will127534/HITCON-Badge-2018/README.md

# HITCON-Badge-2018
HITCON Badge 2018 files
