will127534/HITCON-Badge-2018/Software/Utlity/SecureElement_Uploader/README.md

## Secure Element Upload tool

Usage:
First, Upload relay bin (SLE97Loader.ino.bin) to MT7697  

Second, Run the python program  
``` python
python3 ./SLE97Loader.py. BINFILE COM_PORT
#EX:python3 ./SLE97Loader.py SLE97_20180720.out COM3
```
