will127534/HITCON-Badge-2018/Software/Utlity/UploadTool/README.md

## Linkit 7697 Upload Tool

使用方式如下:

``` 
upload.exe -n da97.bin -c COM5 -f [bin file location]

```
