will127534/HITCON-Badge-2018/Software/Utlity/BMPtobinaryBitmap/HITCON.bmp

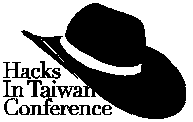
Software/Utlity/BMPtobinaryBitmap/HITCON.bmp
