will127534/HITCON-Badge-2018/Software/Utlity/BMPtobinaryBitmap/Hitcon_L0.bmp

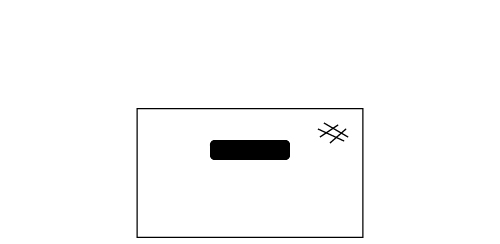
Software/Utlity/BMPtobinaryBitmap/Hitcon_L0.bmp
