will127534/HITCON-Badge-2018/Software/Utlity/BMPtobinaryBitmap/Hitcon_L2.bmp

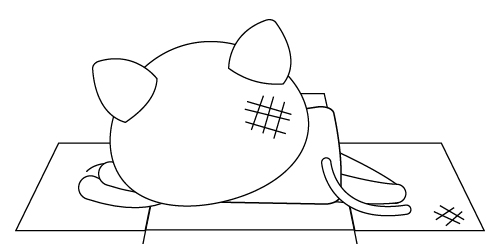
Software/Utlity/BMPtobinaryBitmap/Hitcon_L2.bmp
