will127534/HITCON-Badge-2018/Software/Utlity/BMPtobinaryBitmap/Hitcon_L3a.bmp

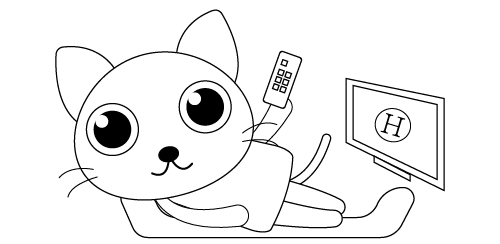
Software/Utlity/BMPtobinaryBitmap/Hitcon_L3a.bmp
