will127534/HITCON-Badge-2018/Software/Utlity/BMPtobinaryBitmap/Hitcon_L4a.bmp

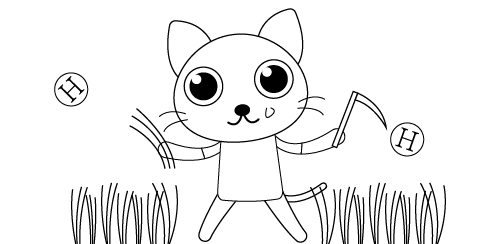
Software/Utlity/BMPtobinaryBitmap/Hitcon_L4a.bmp
