will127534/HITCON-Badge-2018/Software/Utlity/BMPtobinaryBitmap/Hitcon_L5a.bmp

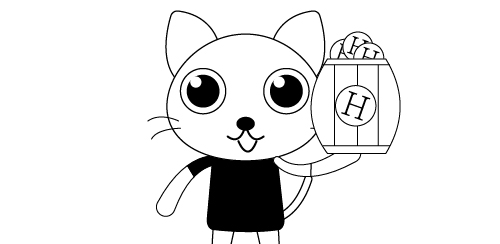
Software/Utlity/BMPtobinaryBitmap/Hitcon_L5a.bmp
