will127534/HITCON-Badge-2018/Software/Utlity/BMPtobinaryBitmap/Hitcon_L7.bmp

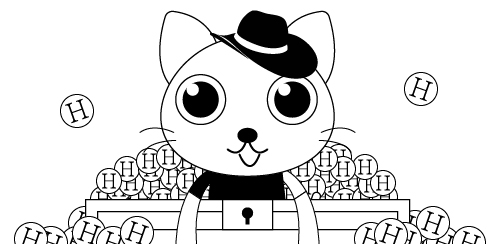
Software/Utlity/BMPtobinaryBitmap/Hitcon_L7.bmp
