will127534/HITCON-Badge-2018/Software/Utlity/BMPtobinaryBitmap/Might.bmp

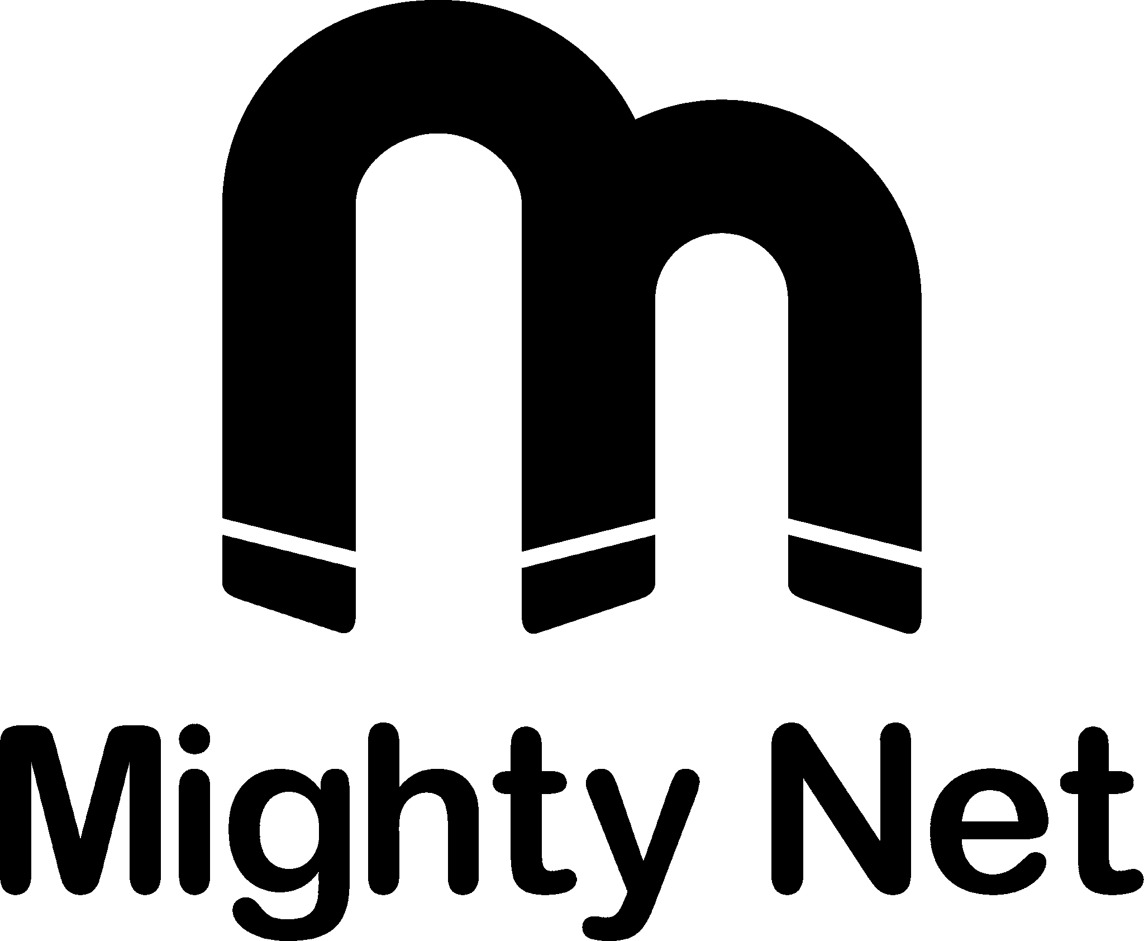
Software/Utlity/BMPtobinaryBitmap/Might.bmp
