will127534/HITCON-Badge-2018/Hardware/HitconBadge2018_Schmetic.pdf

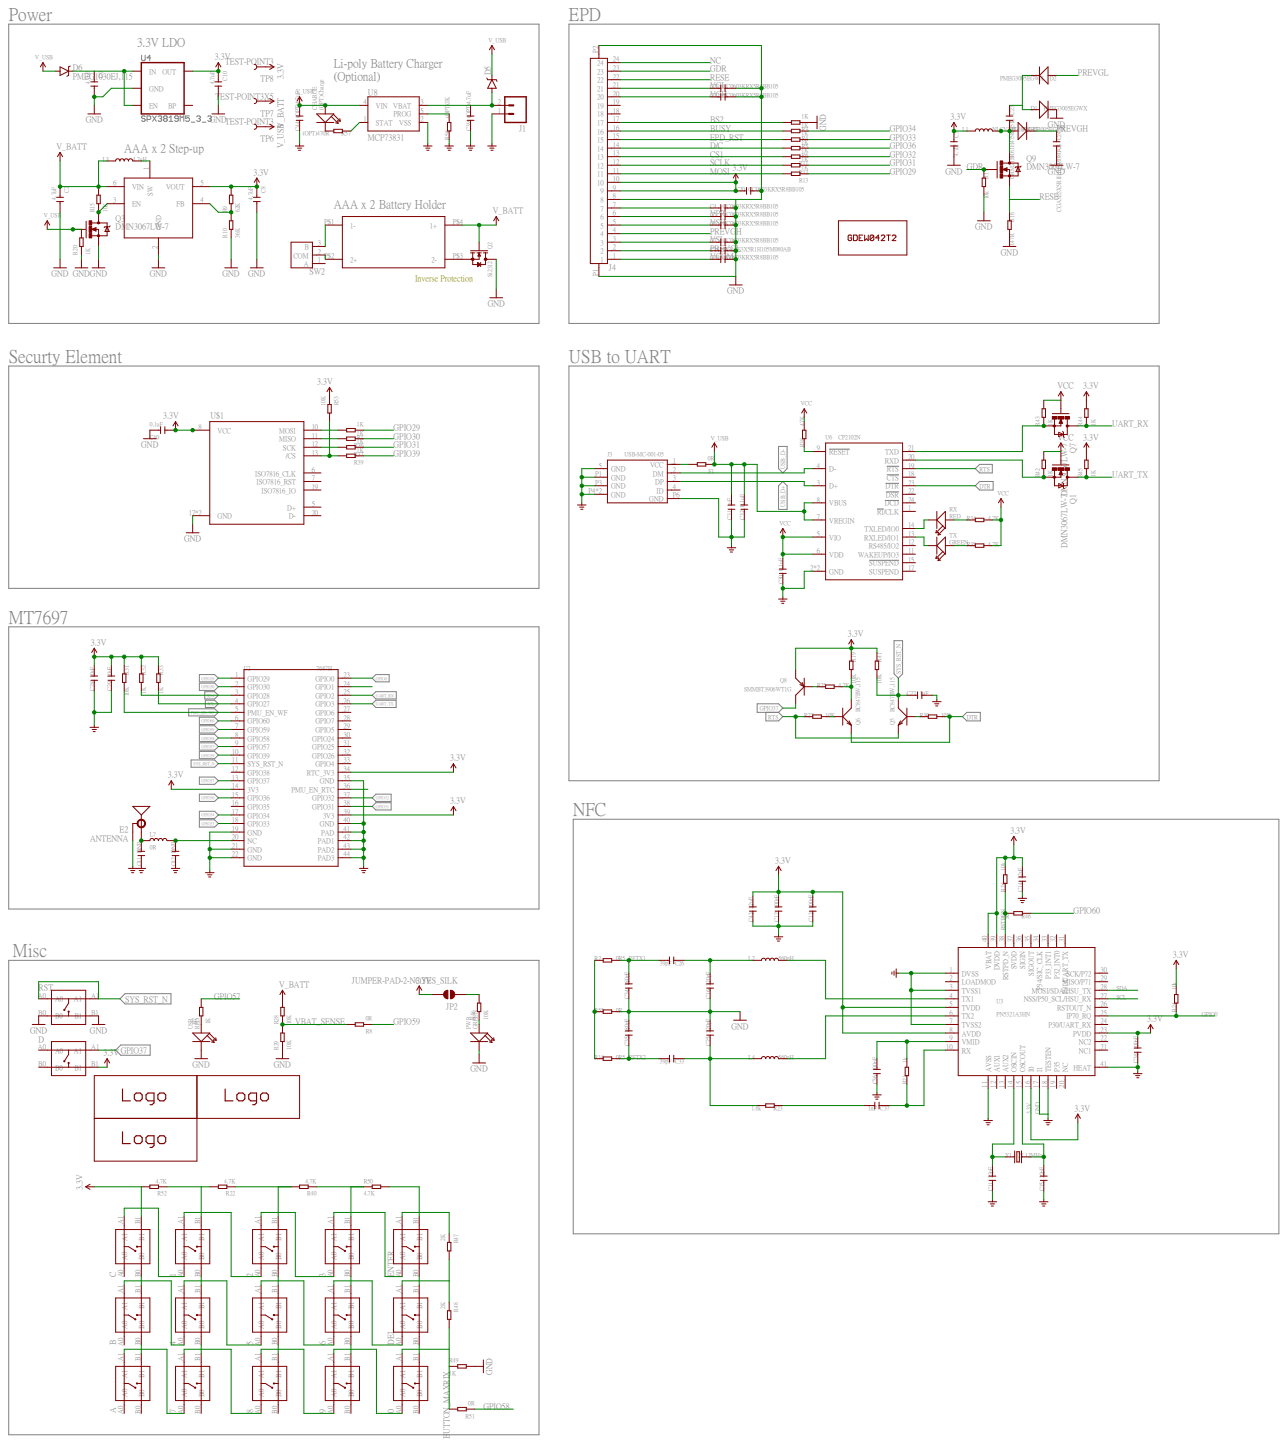
[picture p20: page 1]

Li-poly Battery Charger
