will127534/HITCON-Badge-2018/Hardware/HitconBadge2018_Layout.pdf

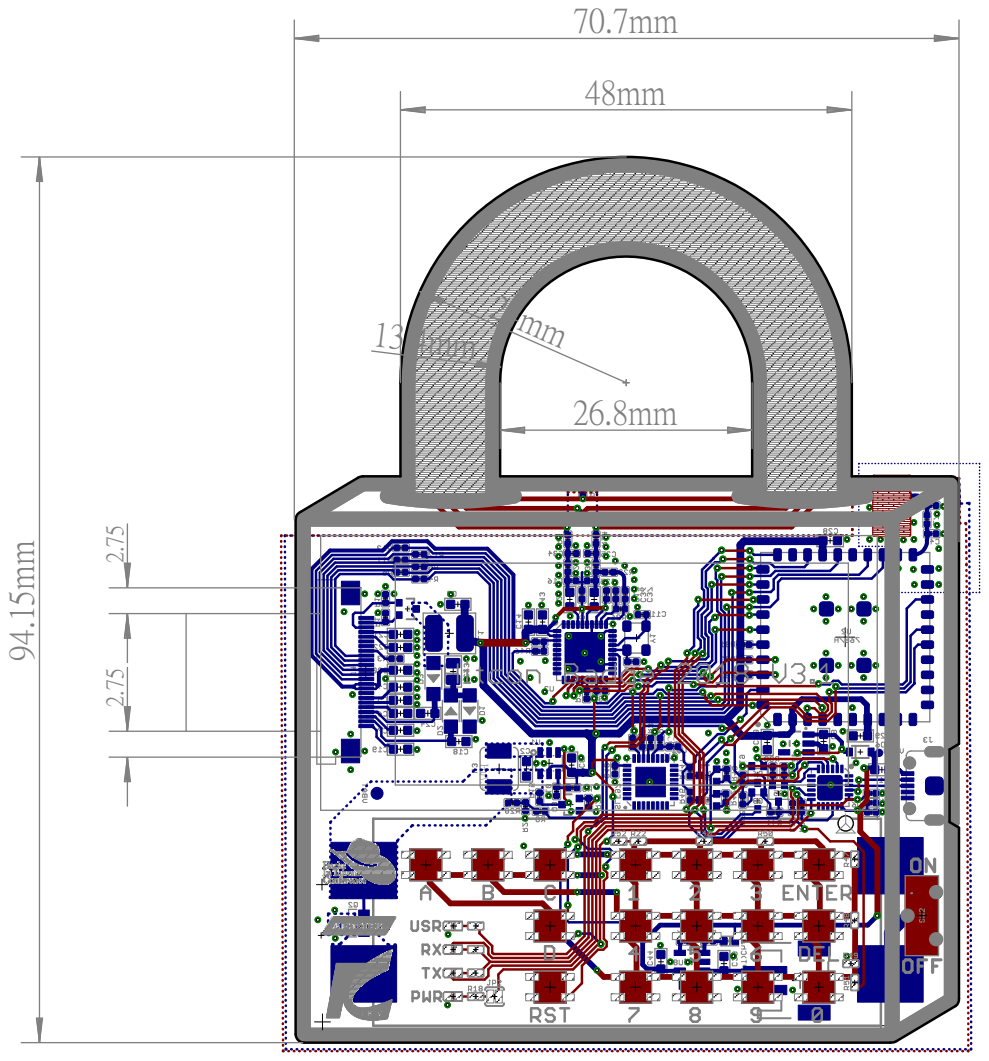
[picture p21: page 1]
