will127534/HITCON-Badge-2018/Hardware/HitconBadge2018.brd

## EAGLE design Hardware/HitconBadge2018.brd (2018-07-26)

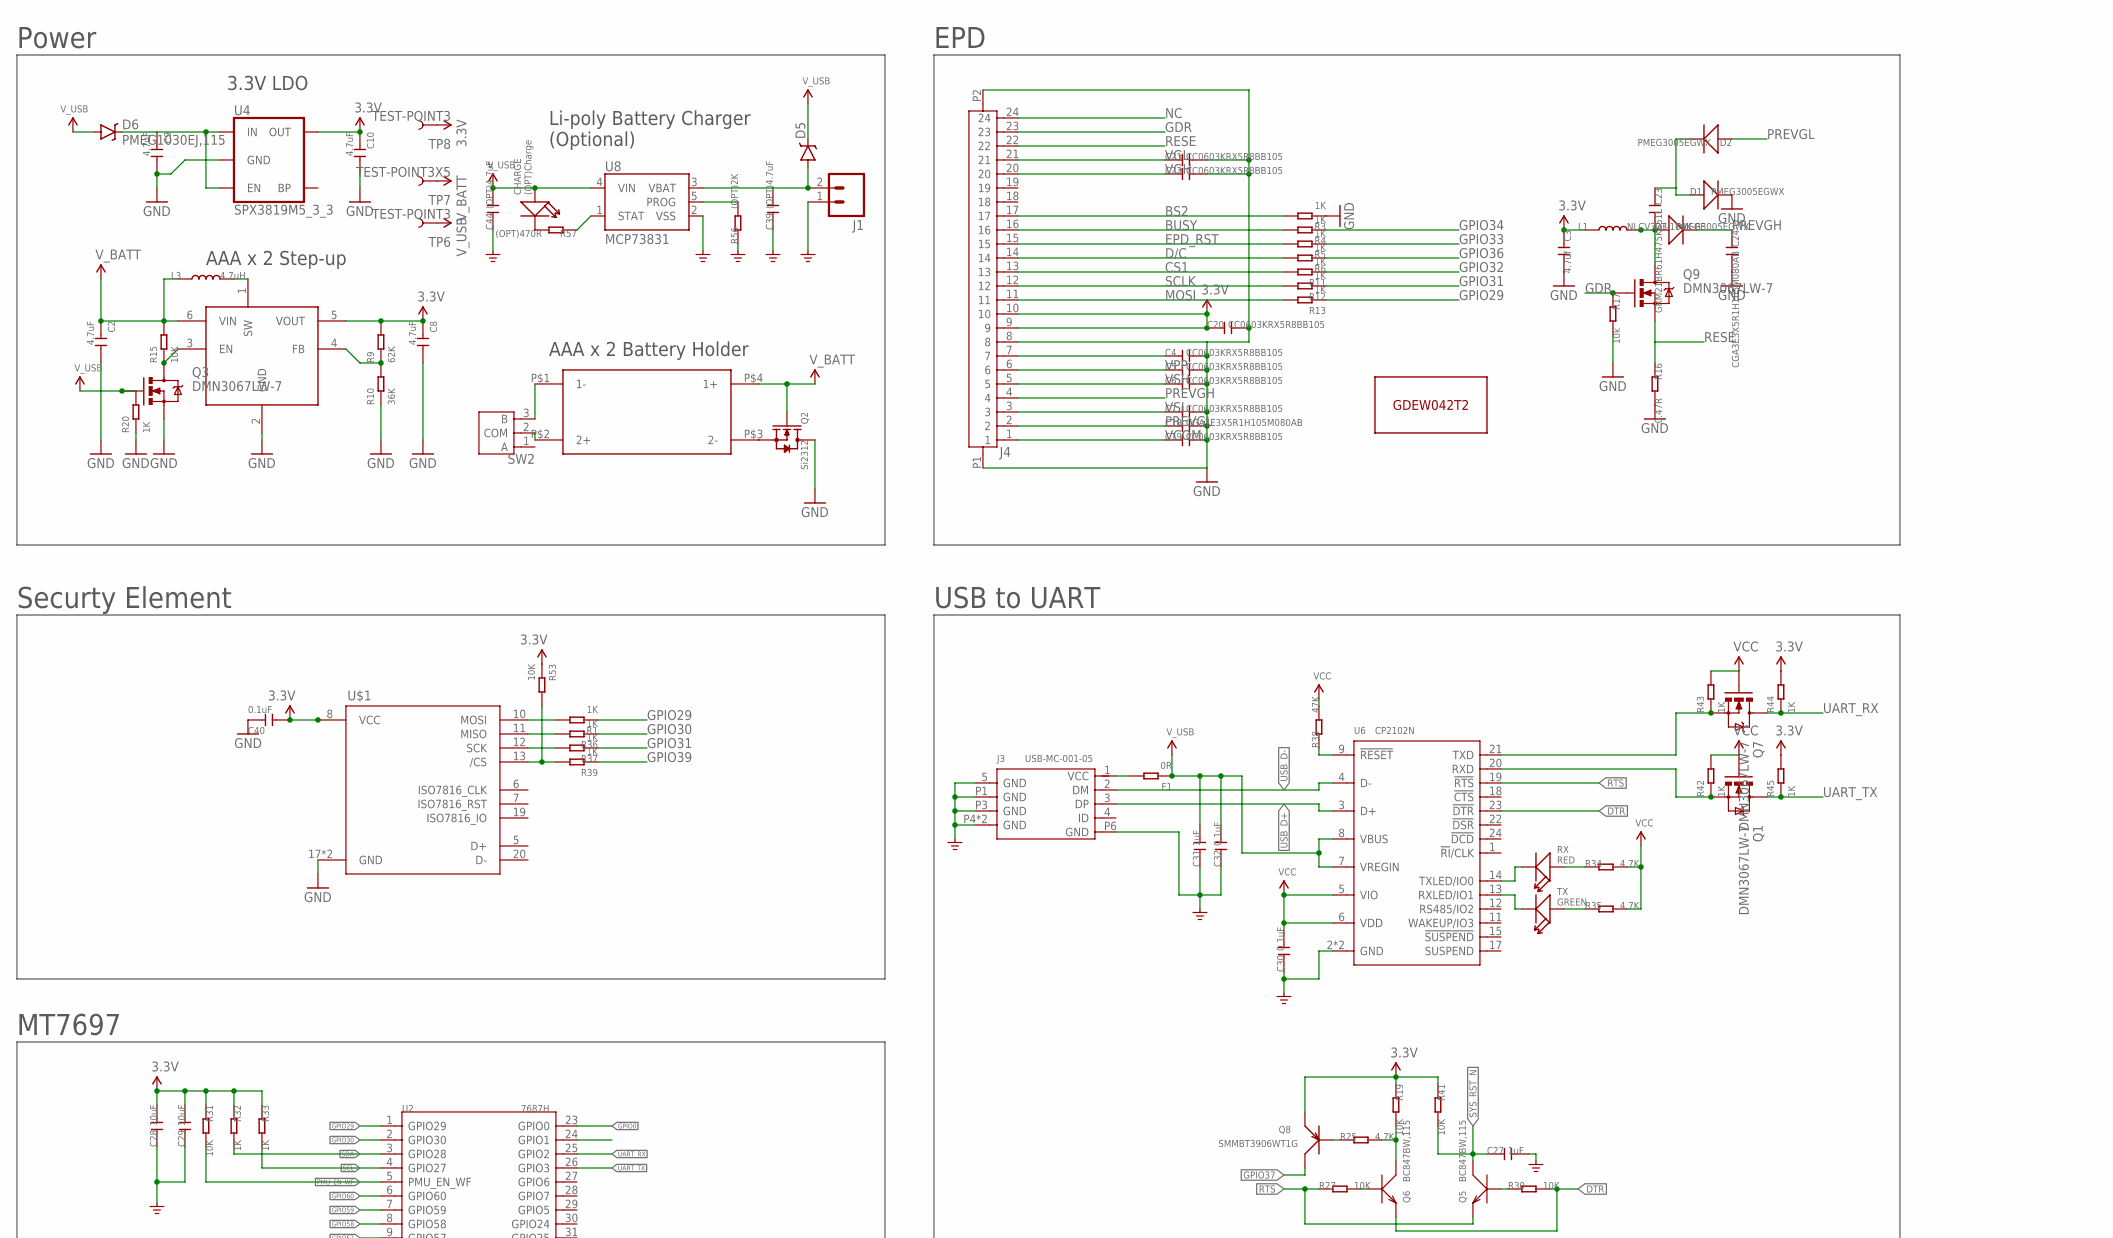
[picture p22: schematic HitconBadge2018.sch, part in row 1, column 1]

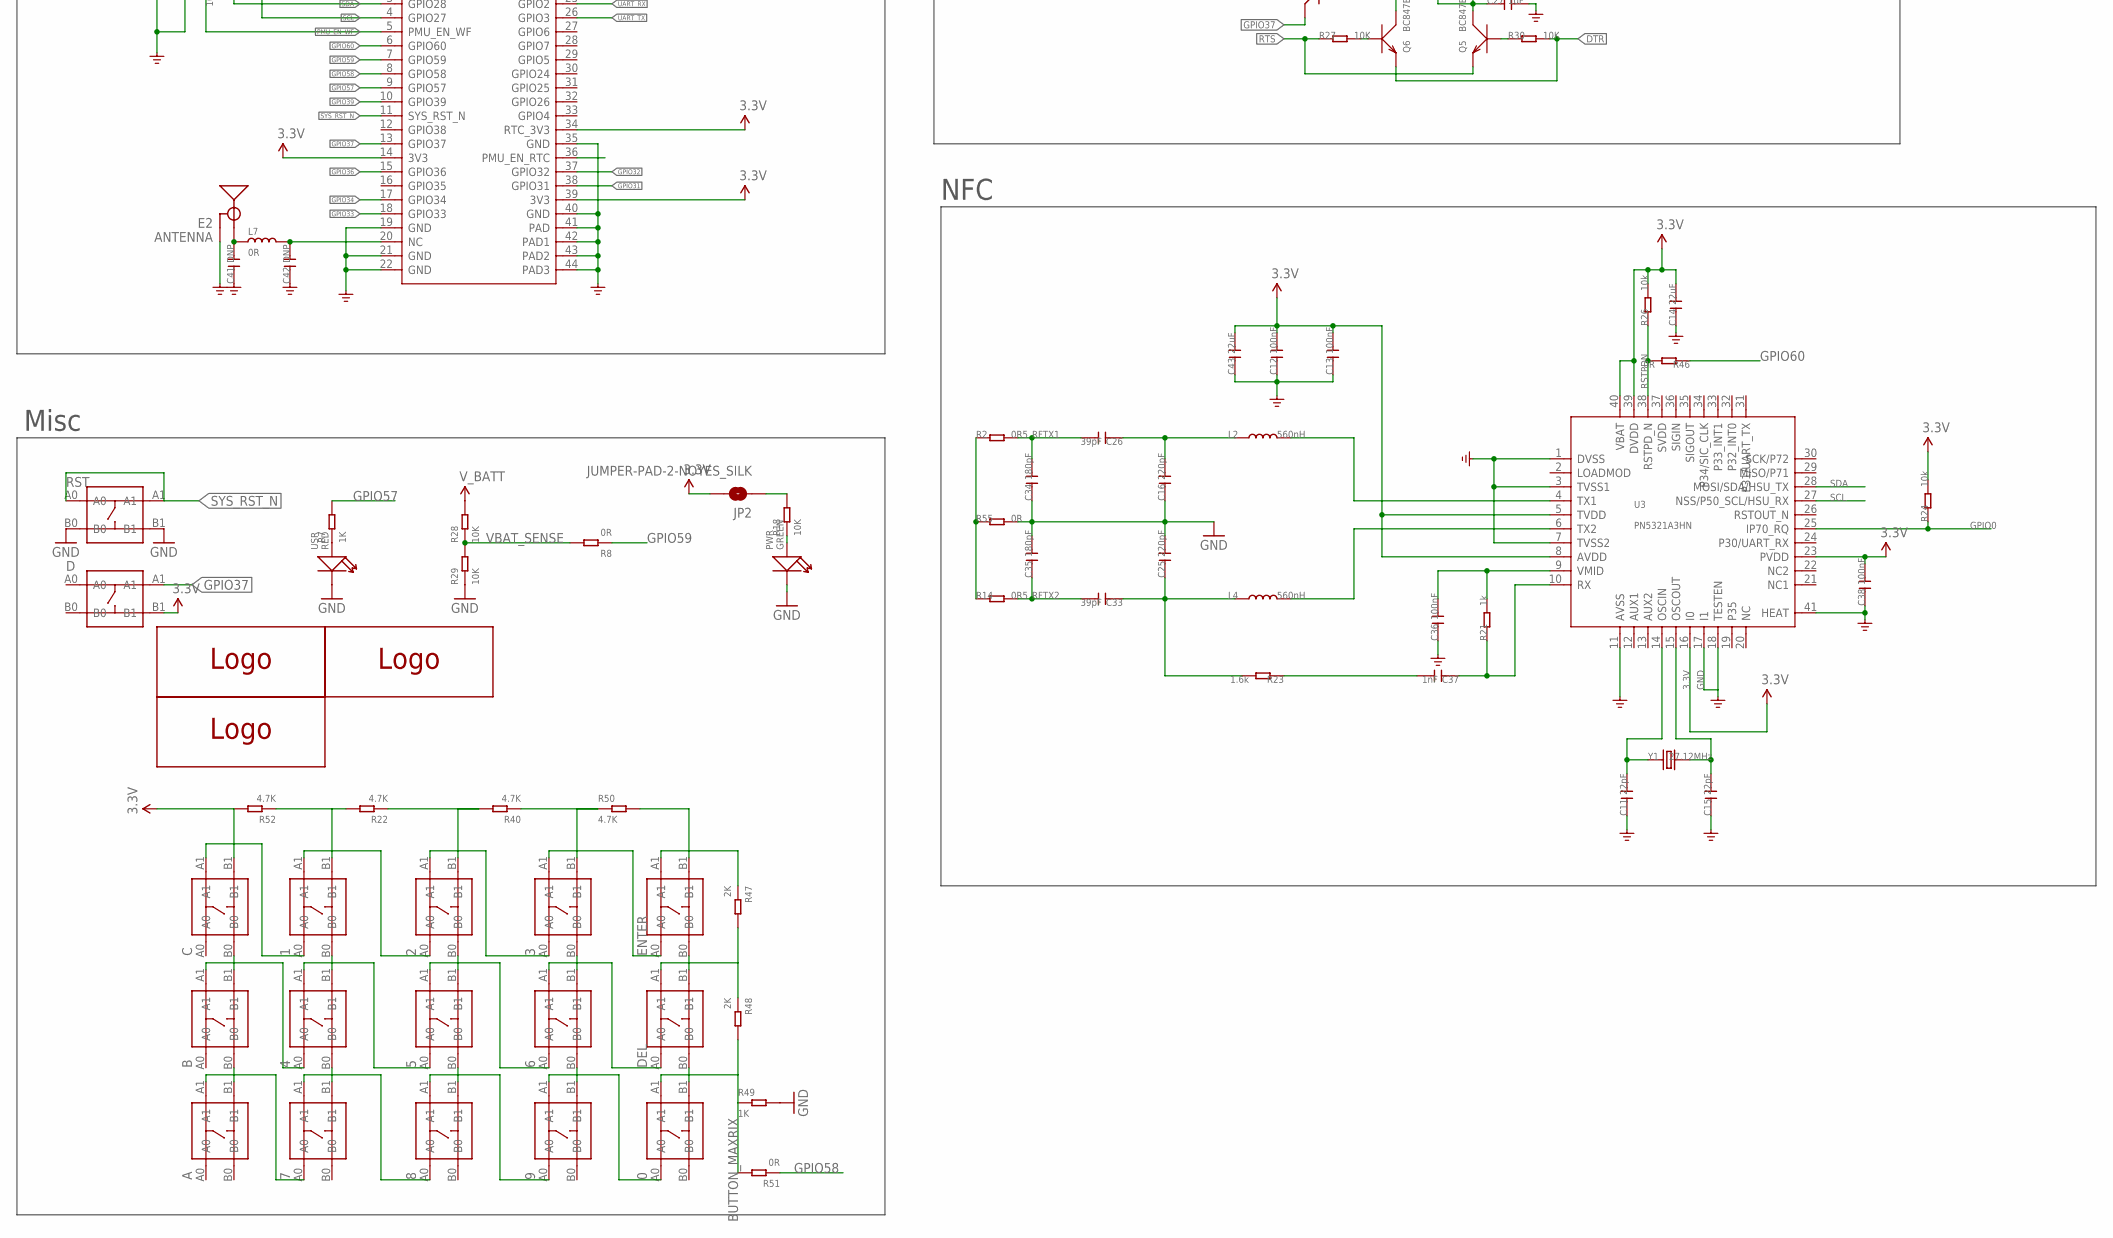
[picture p23: schematic HitconBadge2018.sch, part in row 2, column 1]

Parts:
0, 1, 2, 3, 4, 5, 6, 7, 8, 9: BUTTON-4P-3.3X3.3; 4P-SMD-3.4X3.4X1.3H
A: BUTTON-4P-3.3X3.3; 4P-SMD-3.4X3.4X1.3H
B: BUTTON-4P-3.3X3.3; 4P-SMD-3.4X3.4X1.3H
C: BUTTON-4P-3.3X3.3; 4P-SMD-3.4X3.4X1.3H
C2, C8, C9, C10: 4.7uF; C0603@1
C3: 4.7uf; C0603
C4, C5, C6, C7, C19, C20, C21, C22: CC0603KRX5R8BB105; C0603
C11, C15: 22pF; C0402
C12, C13, C36, C38: 100nF; C0402
C14, C43: 22uF; C0603
C16, C25: 220pF; C0402
C18, C24: CGA3E3X5R1H105M080AB; C0603
C23: GRM21BR61H475KE51L; C0805
C26, C33: 39pF; C0402
C27, C31: 1uF; C0402
C28, C29: 10uF; C0603
C30, C32: 0.1uF; C0402
C34, C35: 180pF; C0402
C37: 1nF; C0402
C39, C44: (OPT)4.7uF; C0603
C40: 0.1uF; C0402@1
C41, C42: DNP; C0402
CHARGE: (OPT)Charge; LED-0603
D: BUTTON-4P-3.3X3.3; 4P-SMD-3.4X3.4X1.3H
D1, D2, D3: PMEG3005EGWX; SOD123
D5: (OPT)PMEG1030EJ,115; SOD-323
D6: PMEG1030EJ,115; SOD-323
DEL: BUTTON-4P-3.3X3.3; 4P-SMD-3.4X3.4X1.3H
E2: ANTENNA; 2450AT18D0100E
ENTER: BUTTON-4P-3.3X3.3; 4P-SMD-3.4X3.4X1.3H
F1: 0R; R0603
J1: M02-JST-2MM-SMT; JST-2-SMD
J3: USB-MC-001-05; MICRO-USB5+5P-SMD-0.65-7.2X5.06MM
J4: FPC-CONNECTOR-24P-0.5'ST-FPC-052024-B'; 24P-0.5
JP2: JUMPER-PAD-2-NOYES_SILK; PAD-JUMPER-2-NO_YES_SILK
L1: NLCV32T-100K-PF; 1813@1
L2, L4: 560nH; L0603@1
L3: 4.7uH; 1616BZ@1
L7: 0R; L0402
PWR: GREEN; LED-0603
Q1, Q3, Q7, Q9: DMN3067LW-7; SOT323
Q2: Si2312; SOT23
Q5, Q6: BC847BW,115; SOT-323
Q8: SMMBT3906WT1G; SOT-323
R1, R3, R4, R5, R6, R7, R11, R12, R13, R20, R32, R33, R36, R37, R39, R42, R43, R44, R45, R49: 1K; R0402
R2, R14: 0R5; R0402
R8, R46, R51, R55: 0R; R0402
R9: 62K; R0402
R10: 36K; R0402
R15, R18, R19, R27, R28, R29, R30, R31, R41, R53: 10K; R0402
R16: 0.47R; R0402
R17, R24, R26: 10k; R0402
R21: 1k; R0402
R22, R25, R34, R35, R40, R50, R52: 4.7K; R0402
R23: 1.6k; R0402
R38: 47K; R0402
R47, R48: 2K; R0402
R56: (OPT)2K; R0402
R57: (OPT)470R; R0402
RST: BUTTON-4P-3.3X3.3; 4P-SMD-3.4X3.4X1.3H
RX: RED; LED-0603
SW2: SWITCH-2H-3P'--'; 3P-2CH-3.54X8.5
TP6, TP8: TEST-POINT3; PAD.03X.03
TP7: TEST-POINT3X5; PAD.03X.05
TX: GREEN; LED-0603
U1: MCP1640; SOT23-6
U2: 7687H; MODULE44P-1.6-18X18X1.3MM
U3: PN5321A3HN; HVQFN40
U4: SPX3819M5_3_3; SOT23-5
U6: CP2102N; QFN24G-0.5-4X4MM
U8: MCP73831; SOT23-5
U$1: SLE97; QFN-32
U$2: HITCON_LOGOHITCON; HITCON_LOGO
U$3: HITCON_LOGOMEDIATEK; MEDIATEK
U$4: AAAX2
U$5: 213
U$6: HITCON_LOGOIKV; IKV
USR: RED; LED-0603
Y1: 27.12MHz; 4P-SMD-3.2X2.5

Connections:
3.3V: C.B1, C3.1, C8.1, C10.1, C12.2, C13.2, C14.2, C20.1, C28.2, C29.2, C38.2, C40.2, C43.2, D.B1, J4.9, J4.10, JP2.2, L1.1, Q8.2 (E), R9.2, R19.1, R24.2, R26.2, R31.1, R32.1, R33.1, R41.1, R44.2, R45.2, R52.2, R53.1, TP8.P$1, U1.5 (VOUT), U2.14 (3V3), U2.34 (RTC_3V3), U2.39 (3V3), U3.5 (TVDD), U3.8 (AVDD), U3.16 (I0), U3.23 (PVDD), U3.39 (DVDD), U3.40 (VBAT), U4.5 (OUT), U$1.8 (VCC)
BS2: J4.17, R3.2
BUSY: J4.16, R4.2
BUTTON_MAXRIX: 0.A1, R48.2, R49.1, R51.2
CS1: J4.13, R11.2
D/C: J4.14, R6.2
DTR: Q6.2 (E), R30.2, U6.23 (!DTR!)
EPD_RST: J4.15, R5.2
GDR: J4.23, Q9.1 (G), R17.1
GND: C2.2, C3.2, C4.2, C5.2, C6.2, C7.2, C8.2, C9.2, C10.2, C11.1, C12.1, C13.1, C14.1, C15.1, C16.1, C18.2, C19.2, C20.2, C21.2, C22.2, C24.2, C25.2, C27.2, C28.1, C29.1, C30.1, C31.1, C32.1, C34.1, C35.2, C36.1, C38.1, C39.1, C40.1, C41.1, C42.1, C43.1, C44.1, D1.-, E2.GND@1 (GND), E2.GND@2 (GND), E2.GND@3 (GND), J1.1 (2), J3.5 (GND), J3.P1 (GND), J3.P3 (GND), J3.P4 (GND), J3.P5 (GND), J3.P6 (GND), J4.8, J4.P1, J4.P2, PWR.-, Q2.3 (D), Q3.2 (S), R3.1, R10.1, R16.2, R17.2, R20.1, R29.1, R49.2, R55.2, R56.1, RST.B0, RST.B1, U1.2 (GND), U2.19 (GND), U2.21 (GND), U2.22 (GND), U2.35 (GND), U2.40 (GND), U2.41 (PAD), U2.42 (PAD1), U2.43 (PAD2), U2.44 (PAD3), U3.1 (DVSS), U3.3 (TVSS1), U3.7 (TVSS2), U3.11 (AVSS), U3.17 (I1), U3.18 (TESTEN), U3.41 (HEAT), U4.2 (GND), U6.2 (GND), U6.PAD (GND), U8.2 (VSS), U$1.17 (GND), U$1.EP (GND), USR.-
GPIO0: R24.1, U2.23 (GPIO0), U3.25 (IP70_RQ)
GPIO29: R1.1, R13.1, U2.1 (GPIO29)
GPIO30: R36.1, U2.2 (GPIO30)
GPIO31: R12.1, R37.1, U2.38 (GPIO31)
GPIO32: R11.1, U2.37 (GPIO32)
GPIO33: R5.1, U2.18 (GPIO33)
GPIO34: R4.1, U2.17 (GPIO34)
GPIO36: R6.1, U2.15 (GPIO36)
GPIO37: D.A1, Q8.3 (C), U2.13 (GPIO37)
GPIO39: R39.1, U2.10 (GPIO39)
GPIO57: R7.2, U2.9 (GPIO57)
GPIO58: R51.1, U2.8 (GPIO58)
GPIO59: R8.1, U2.7 (GPIO59)
GPIO60: R46.1, U2.6 (GPIO60)
MOSI: J4.11, R13.2
unnamed: C11.2, U3.14 (OSCIN), Y1.2 (1)
unnamed: L3.2, U1.1 (SW)
unnamed: C23.1, D1.+, D2.-
unnamed: SW2.3 (B), U$4.P$1 (1-)
unnamed: R7.1, USR.+
unnamed: R9.1, R10.2, U1.4 (FB)
unnamed: Q3.3 (D), R15.1, U1.3 (EN)
unnamed: C15.2, U3.15 (OSCOUT), Y1.4 (2)
unnamed: L4.2, U3.6 (TX2)
unnamed: L2.2, U3.4 (TX1)
unnamed: C4.1, J4.7
unnamed: C16.2, C26.1, L2.1
unnamed: C23.2, D3.+, L1.2, Q9.3 (D)
unnamed: C25.1, C33.1, L4.1, R23.2
unnamed: C36.2, R21.2, U3.9 (VMID)
unnamed: C37.1, R21.1, U3.10 (RX)
unnamed: C37.2, R23.1
unnamed: 4.B0, 7.B1
unnamed: C41.2, E2.FEED (SIGNAL), L7.1
unnamed: 1.B0, 4.B1
unnamed: SW2.2 (COM), U$4.P$2 (2+)
unnamed: C9.1, D6.C, U4.1 (IN), U4.3 (EN)
unnamed: R56.2, U8.5 (PROG)
unnamed: 5.B0, 8.B1
unnamed: C42.2, L7.2, U2.20 (NC)
unnamed: R1.2, U$1.10 (MOSI)
unnamed: R36.2, U$1.11 (MISO)
unnamed: R37.2, U$1.12 (SCK)
unnamed: R39.2, R53.2, U$1.13 (/CS)
unnamed: 2.B0, 5.B1
unnamed: 2.B1, R22.1, R40.2
unnamed: 6.B0, 9.B1
unnamed: 3.B0, 6.B1
unnamed: 3.B1, R40.1, R50.1
unnamed: 0.B1, DEL.B0
unnamed: DEL.B1, ENTER.B0
unnamed: ENTER.B1, R50.2
unnamed: PWR.+, R18.1
unnamed: JP2.1, R18.2
unnamed: F1.2, J3.1 (VCC)
unnamed: Q5.1 (B), R30.1
unnamed: Q6.1 (B), R27.2
unnamed: Q6.3 (C), R19.2, R25.2
unnamed: Q8.1 (B), R25.1
unnamed: R35.1, TX.+
unnamed: R34.1, RX.+
unnamed: TX.-, U6.13 (RXLED/IO1)
unnamed: RX.-, U6.14 (TXLED/IO0)
unnamed: R38.1, U6.9 (!RESET!)
unnamed: Q1.2 (S), R42.1, U6.20 (RXD)
unnamed: Q7.2 (S), R43.1, U6.21 (TXD)
unnamed: 6.A1, DEL.A0
unnamed: 3.A1, ENTER.A0
unnamed: 7.A1, 8.A0
unnamed: 8.A1, 9.A0
unnamed: 0.A0, 9.A1
unnamed: 4.A1, 5.A0
unnamed: 5.A1, 6.A0
unnamed: DEL.A1, R47.2, R48.1
unnamed: 1.A1, 2.A0
unnamed: 2.A1, 3.A0
unnamed: ENTER.A1, R47.1
unnamed: R2.1, R14.1, R55.1
unnamed: Q2.2 (S), U$4.P$3 (2-)
unnamed: R57.1, U8.1 (STAT)
unnamed: CHARGE.-, R57.2
unnamed: 1.B1, R22.2, R52.1
unnamed: C39.2, D5.A, J1.2 (1), U8.3 (VBAT)
unnamed: B.B1, C.B0
unnamed: A.B1, B.B0
unnamed: 7.A0, A.A1
unnamed: 4.A0, B.A1
unnamed: 1.A0, C.A1
NC: J4.24
PMU_EN_RTC: U2.36 (PMU_EN_RTC)
PMU_EN_WF: R31.2, U2.5 (PMU_EN_WF)
PREVGH: C24.1, D3.-, J4.4
PREVGL: C18.1, D2.+, J4.2
RESE: J4.22, Q9.2 (S), R16.1
RFTX1: C26.2, C34.2, R2.2
RFTX2: C33.2, C35.1, R14.2
RSTPDN: R26.1, R46.2, U3.38 (RSTPD_N)
RTS: Q5.2 (E), R27.1, U6.19 (!RTS!)
SCL: R33.2, U2.4 (GPIO27), U3.27 (NSS/P50_SCL/HSU_RX)
SCLK: J4.12, R12.2
SDA: R32.2, U2.3 (GPIO28), U3.28 (MOSI/SDA/HSU_TX)
SYS_RST_N: C27.1, Q5.3 (C), R41.2, RST.A0, RST.A1, U2.11 (SYS_RST_N)
UART_RX: Q7.3 (D), R44.1, U2.25 (GPIO2)
UART_TX: Q1.3 (D), R45.1, U2.26 (GPIO3)
USB_D+: J3.3 (DP), U6.3 (D+)
USB_D-: J3.2 (DM), U6.4 (D-)
VBAT_SENSE: R8.2, R28.1, R29.2
VCC: C30.2, Q1.1 (G), Q7.1 (G), R34.2, R35.2, R38.2, R42.2, R43.2, U6.5 (VIO), U6.6 (VDD)
VCOM: C19.1, J4.1
VGH: C22.1, J4.20
VGL: C21.1, J4.21
VPP: C5.1, J4.6
VSH: C6.1, J4.5
VSL: C7.1, J4.3
V_BATT: C2.1, L3.1, Q2.1 (G), R15.2, R28.2, TP7.P$1, U1.6 (VIN), U$4.P$4 (1+)
V_USB: C31.2, C32.2, C44.2, CHARGE.+, D5.C, D6.A, F1.1, Q3.1 (G), R20.2, TP6.P$1, U6.7 (VREGIN), U6.8 (VBUS), U8.4 (VIN)

Notes on the sheet:
Misc
Power
EPD
MT7697
USB to UART
NFC
Securty Element
3.3V LDO
Li-poly Battery Charger (Optional)
AAA x 2 Step-up
AAA x 2 Battery Holder

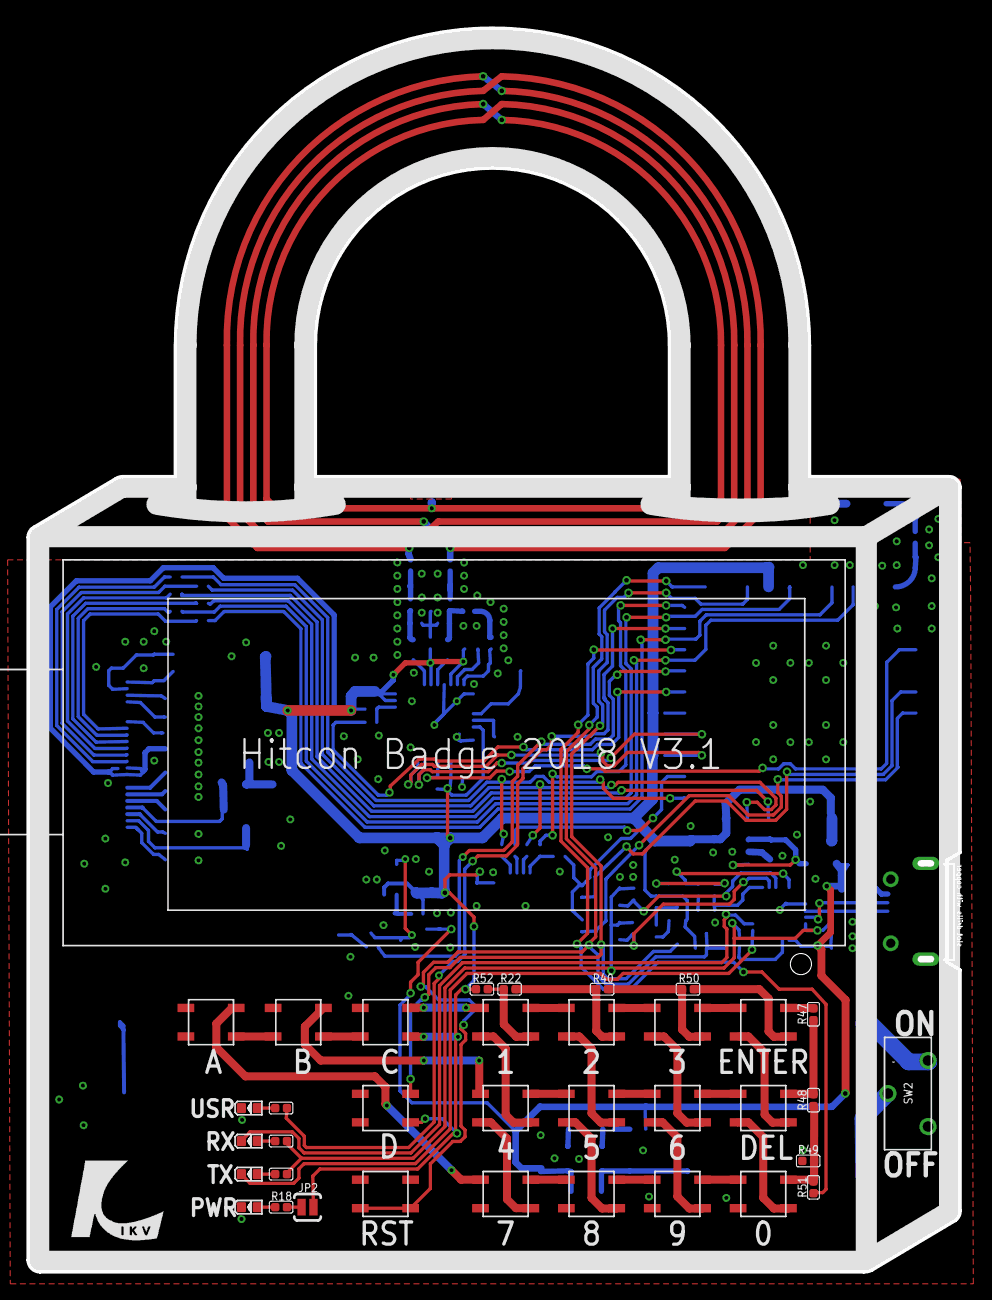
[picture p24: board HitconBadge2018.brd from above]

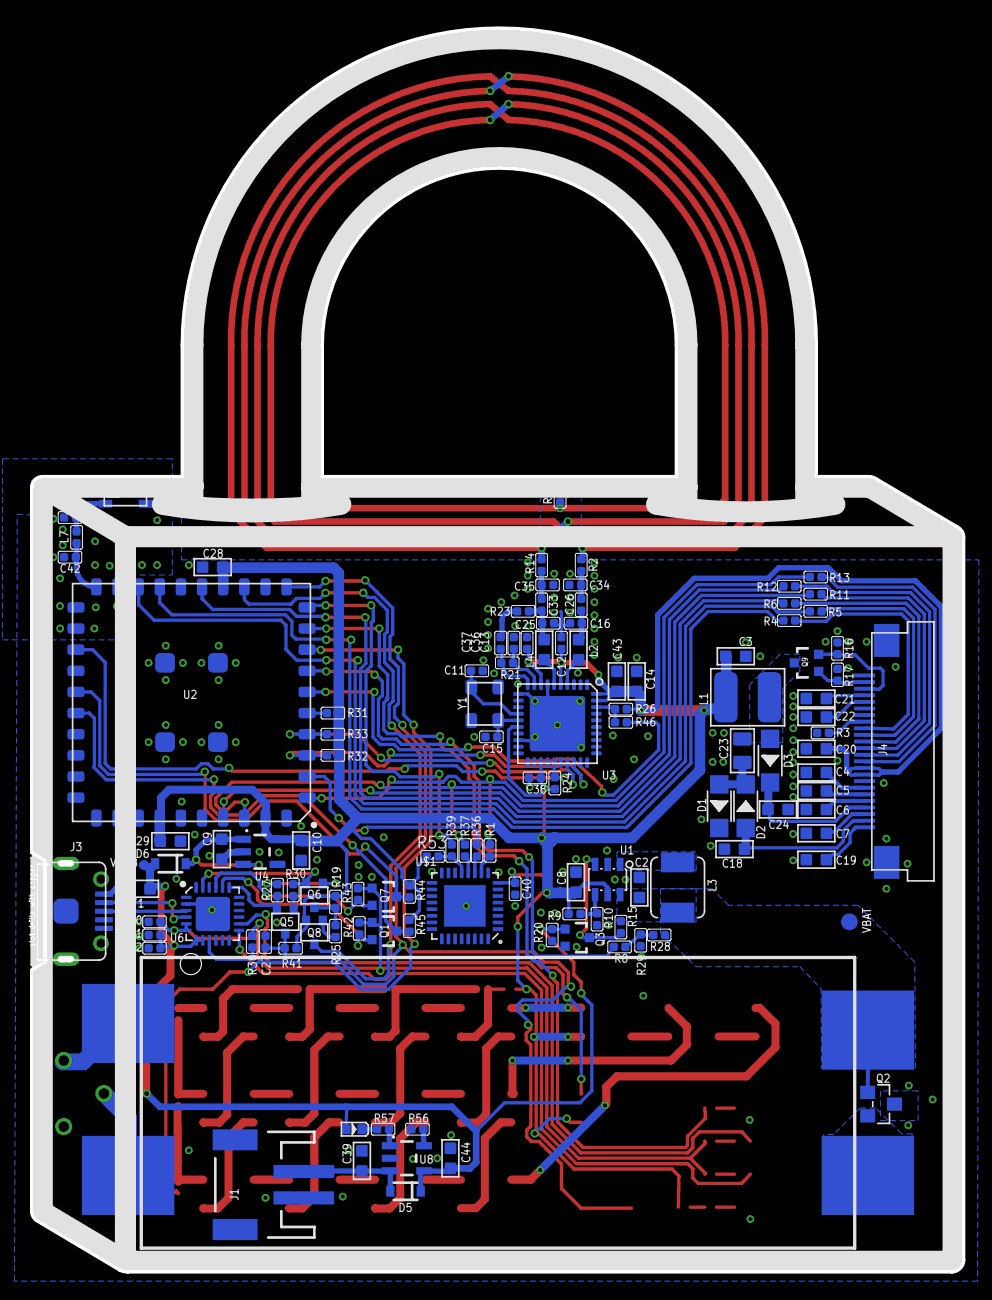
[picture p25: board HitconBadge2018.brd from below]

Board: 2 copper layers, 70.6 x 94.2 mm, 161 parts (123 on the bottom side), 124 nets.
