will127534/HITCON-Badge-2018/Software/HitconBadge2018/icon.h

const uint8_t Might []  = {// 148 x 122 
	0,0,0,0,0,0,31,252,0,0,0,0,0,0,0,0,0,0,0,//19
	0,0,0,0,0,1,255,255,192,0,0,0,0,0,0,0,0,0,0,//19
	0,0,0,0,0,15,255,255,248,0,0,0,0,0,0,0,0,0,0,//19
	0,0,0,0,0,63,255,255,254,0,0,0,0,0,0,0,0,0,0,//19
	0,0,0,0,0,127,255,255,255,0,0,0,0,0,0,0,0,0,0,//19
	0,0,0,0,1,255,255,255,255,192,0,0,0,0,0,0,0,0,0,//19
	0,0,0,0,3,255,255,255,255,224,0,0,0,0,0,0,0,0,0,//19
	0,0,0,0,7,255,255,255,255,240,0,0,0,0,0,0,0,0,0,//19
	0,0,0,0,15,255,255,255,255,248,0,0,0,0,0,0,0,0,0,//19
	0,0,0,0,31,255,255,255,255,252,0,0,0,0,0,0,0,0,0,//19
	0,0,0,0,63,255,255,255,255,254,0,0,0,0,0,0,0,0,0,//19
	0,0,0,0,127,255,255,255,255,255,0,0,0,0,0,0,0,0,0,//19
	0,0,0,0,127,255,255,255,255,255,128,0,0,0,0,0,0,0,0,//19
	0,0,0,0,255,255,255,255,255,255,128,255,224,0,0,0,0,0,0,//19
	0,0,0,0,255,255,255,255,255,255,207,255,252,0,0,0,0,0,0,//19
	0,0,0,1,255,255,255,255,255,255,255,255,255,128,0,0,0,0,0,//19
	0,0,0,1,255,255,255,255,255,255,255,255,255,192,0,0,0,0,0,//19
	0,0,0,3,255,255,254,31,255,255,255,255,255,240,0,0,0,0,0,//19
	0,0,0,3,255,255,240,3,255,255,255,255,255,248,0,0,0,0,0,//19
	0,0,0,3,255,255,192,1,255,255,255,255,255,254,0,0,0,0,0,//19
	0,0,0,7,255,255,128,0,127,255,255,255,255,255,0,0,0,0,0,//19
	0,0,0,7,255,255,0,0,63,255,255,255,255,255,128,0,0,0,0,//19
	0,0,0,7,255,254,0,0,63,255,255,255,255,255,128,0,0,0,0,//19
	0,0,0,7,255,254,0,0,31,255,255,255,255,255,192,0,0,0,0,//19
	0,0,0,7,255,252,0,0,31,255,255,255,255,255,224,0,0,0,0,//19
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
	0,0,0,0,0,0,0,0,0,4,1,0,0,0,0,16,252,33,0,0,0,0,0,0,0,0,0,0,0,0,0,0,//32
	0,0,0,0,0,0,0,0,0,2,1,0,0,0,0,33,254,32,128,0,0,0,0,0,0,0,0,0,0,0,0,0,//32
	0,0,0,0,0,0,0,0,0,2,2,0,0,0,0,32,127,144,64,0,0,0,0,0,0,0,0,0,0,0,0,0,//32
	0,0,0,0,0,0,0,0,0,1,2,2,128,0,0,32,63,136,64,0,0,0,0,0,0,0,0,0,0,0,0,0,//32
	0,0,0,0,0,0,0,0,0,1,4,12,112,0,0,72,127,200,32,0,0,0,0,0,0,0,0,0,0,0,0,0,//32
	0,0,0,0,84,0,0,0,0,0,136,48,12,0,0,76,127,192,32,0,0,0,0,0,0,0,0,0,0,0,0,0,//32
	0,0,0,1,1,0,0,0,0,0,136,65,66,0,0,15,255,200,16,0,0,0,0,0,0,0,0,0,0,0,0,0,//32
	0,0,0,2,16,128,0,0,0,0,64,135,241,0,0,79,255,200,16,0,0,0,0,0,0,0,0,0,0,0,0,0,//32
	0,0,0,4,32,64,0,0,0,0,80,131,248,128,0,79,255,192,0,0,0,0,0,0,0,0,0,0,0,0,0,0,//32
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
};
