will127534/HITCON-Badge-2018/Software/HitconBadge2018/cmdline_interface.hpp

void init_cmdline_interface();
void ReadVoltage_cmd(int arg_cnt, char **args);
void ReinitBLE_cmd(int arg_cnt, char **args);
void InitDevInfo_cmd(int arg_cnt, char **args);
void BindLogin_cmd(int arg_cnt, char **args);
void BindLogout_cmd(int arg_cnt, char **args);
void BackToNoHost_cmd(int arg_cnt, char **args);
void hdw_query_wallet_info_cmd(int arg_cnt, char **args);
void hdw_query_account_key_info_cmd(int arg_cnt, char **args);
void cmdline_interface_process();
void hello(int arg_cnt, char **args);
