will127534/HITCON-Badge-2018/Software/HitconBadge2018/BLE.hpp

#ifndef _BLE_hpp_
#define _BLE_hpp_

#include <LBLE.h>
#include <LBLEPeriphral.h>



extern LBLEService* ExchangeService;
extern LBLECharacteristicBuffer* Transaction_GATT; 
extern LBLECharacteristicBuffer* Txn_GATT; 
extern LBLECharacteristicBuffer* AddERC20_GATT; 
extern LBLECharacteristicBuffer* Balance_GATT; 
extern LBLECharacteristicBuffer* General_CMD_GATT; 
extern LBLECharacteristicBuffer* General_Data_GATT; 

extern LBLEService* BatteryService;
extern LBLECharacteristicBuffer* Battery_Level_GATT; 

extern bool NewBalanceFlag;

/// Initialize BLE
void init_BLE();

/// Process BLE write
///
/// \returns if needed to refresh screen
bool Process_BLE();

/// Regeneratee BLE Service and charastic UUID
void regenerate_BLE_parameter();

#endif // _BLE_hpp_
