will127534/HITCON-Badge-2018/Software/HitconBadge2018/util.hpp

#ifndef _util_hpp_
#define _util_hpp_

#include <vector>
#include "Arduino.h"
#include "uint256.hpp"
void sha256_data( uint8_t *message, uint8_t len, uint8_t *digest);
String ArraytoString_binary(uint8_t* buffer,uint32_t len);
uint16_t BinaryStringtoArray(String data);
String ArraytoString(uint8_t* buffer,uint32_t len,uint32_t String_len);
String ArraytoString(uint8_t* buffer,uint32_t len);
String vector2string(std::vector<uint8_t> VEC);
void print_vector(std::vector<uint8_t> VEC);
void randomNumbergenerator_init();
uint32_t randomNumbergenerator(uint8_t digit);
uint32_t randomUint32_t_generator();
void random_UUID_generator(char* array);
void random_UUID_generator_head(char* array);
void WDT_Reset();
String vector2string_DEC(std::vector<uint8_t> data,uint8_t quanty);
void convertUint256BE(uint8_t *data, uint32_t length, uint256_t *target);



#endif // _util_hpp_
