will127534/HITCON-Badge-2018/(commit log)

2018-05-11 Adding ERC20 support 0.1 and fix RLP encoder bug
    [BLE.cpp, util.cpp, util.hpp, wallet.cpp]
2018-06-20 adding Arduino Packages
2018-06-20 update Arduino Packages json
2018-06-22 adding Battery Service
2018-07-04 fix nonce 15 error
    [BLE.cpp, epddisplay.cpp, util.cpp]
2018-07-26 Ver 1.0
    [HitconBadge2018.brd, HitconBadge2018.sch]
2018-07-28 Add powerpoint
2018-09-18 Update SE firmware
    Update SE firmware for auto clear data when Pin code failed 10 times,
    which SE will go back to NO HOST mode.
